sg9242182-bot/ThashuRobot/thashu/vision/data/faces/person_20/1.jpg

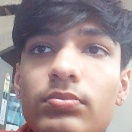
thashu/vision/data/faces/person_20/1.jpg
