sg9242182-bot/ThashuRobot/thashu/vision/data/faces/person_20/2.jpg

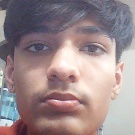
thashu/vision/data/faces/person_20/2.jpg
