sg9242182-bot/ThashuRobot/thashu/vision/data/faces/person_19/0.jpg

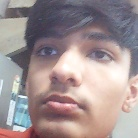
thashu/vision/data/faces/person_19/0.jpg
