sg9242182-bot/ThashuRobot/thashu/tests/vision_test.py

import cv2

cap = cv2.VideoCapture(0, cv2.CAP_V4L2)

cap.set(cv2.CAP_PROP_FOURCC, cv2.VideoWriter_fourcc(*'MJPG'))
cap.set(cv2.CAP_PROP_FRAME_WIDTH, 640)
cap.set(cv2.CAP_PROP_FRAME_HEIGHT, 480)

while True:
    ret, frame = cap.read()
    if not ret:
        print("FAILED")
        continue

    cv2.imshow("test", frame)

    if cv2.waitKey(1) & 0xFF == 27:
        break

cap.release()
cv2.destroyAllWindows()
