sg9242182-bot/ThashuRobot/(commit log)

2026-09-04 Initialize Thashu repository architecture and team workflow
    ## Development & Access Rules
    All team members may freely develop within their assigned areas. These rules exist to prevent accidental integration failures, not to restrict normal development.
    ### Rules for Niteshvar and Vishal Raj
    1. **Do not develop directly on `main`.** Use a dedicated feature/fix branch.
    2. **Do not change the approved system architecture without team approval.**
    3. **Do not silently change shared interfaces**, including APIs, communication protocols, message formats, schemas, shared data structures, or hardware/software contracts.
    4. **Do not modify another member's owned subsystem without coordination.**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
    [command_parser.cpp, command_parser.h]
2026-09-05 Add three-sensor ToF manager interface
2026-09-05 Implement three VL53L0X ToF sensors
2026-09-05 Implement three-sensor ToF manager
2026-09-05 Print ToF distance unless out of range
2026-09-05 Fix ToF manager with non-blocking continuous ranging
    [tof_manager.cpp]
2026-09-05 Print ToF test output only on obstacle detection
2026-09-06 Optimize settled eye rendering and 400kHz I2C
2026-09-06 Ensure final eye frame is rendered after transitions
2026-10-02 Add motor encoder support and proposed pin map
2026-10-03 Restore ultrasonic echo to boot-safe baseline GPIO36
2026-10-03 Correct ultrasonic pin note after GPIO12 boot failure
2026-10-03 Assign fourth encoder input to GPIO15
2026-10-03 Move provisional tilt servo signal to GPIO12
2026-10-03 Assign provisional encoder 4 GPIO and document reset validation
2026-10-03 Record provisional fourth encoder GPIO mapping
2026-10-04 Record tilt servo movement result and remaining reset test
2026-10-04 Record GPIO12 tilt servo result in Phase 1 notes
2026-10-04 Add PlatformIO environment for motor and encoder bench test
2026-10-04 Document integrated PlatformIO motor test procedure
2026-10-05 Pin VL53L0X library to official Adafruit release
2026-10-05 Add PlatformIO entry wrapper for motor sketch
2026-10-05 Compile motor sketch through PlatformIO C++ entry point
2026-10-05 Add motor sketch include directory for PlatformIO wrapper
2026-10-05 Add Arduino IDE integrated motor encoder test entry point
2026-10-05 Document Arduino IDE integrated encoder test path
2026-10-05 Record Arduino IDE integration test route
2026-10-05 Remove temporary Arduino IDE test wrapper
2026-10-05 Remove temporary build tool instructions from pin allocation
2026-10-05 Add integrated Arduino ESP32 runtime
2026-10-05 Gate integrated turns on both safety sensors
2026-10-05 Record integrated Arduino ESP32 runtime status
2026-10-05 Keep motor manager focused on motor hardware
2026-10-05 Track active movement in safety manager
2026-10-05 Add dedicated ESP32 communication manager
2026-10-05 Connect telemetry to sensor managers
2026-10-05 Expose ultrasonic reading freshness
2026-10-05 Track freshness of ultrasonic readings
2026-10-05 Feed safety watchdog from accepted protocol frames
2026-10-05 Reject stale rear ultrasonic data
2026-10-05 Document dedicated ESP32 manager ownership
2026-10-05 Remove superseded monolithic motor sketch
2026-10-05 Expose servo readiness
2026-10-05 Expose motor controller readiness
2026-10-05 Track OLED runtime health
2026-10-05 Probe OLED bus health for safety supervision
2026-10-05 Report required display and sensor startup failures
2026-10-11 Complete Phase 1 ESP32 firmware updates
2026-10-11 Align encoder ID mapping with Phase 1 pin allocation
2026-10-11 Keep safety sensor updates active on hardware fault
2026-10-11 Record serial readiness and sensor refresh finding
2026-10-15 Add servo startup diagnostics
2026-10-15 Avoid LEDC allocation during motor startup stop
2026-10-15 Track motor PWM channels for safe startup stop
2026-10-15 Preserve motor PWM stop while reserving servo channels
2026-10-15 Add isolated motor manager bench test sketch
2026-10-15 Replace stale motors sketch with isolated module test
2026-10-15 Remove misplaced nested motor test sketch
2026-10-15 Interpret motor test speed as percent up to 80
2026-10-15 Restore raw PWM command handling in motor test
2026-10-15 Allow full PWM range in isolated motor test
2026-10-17 Make camera capture lifecycle idempotent
2026-10-17 Test vision pause resume and actuator gating
2026-10-17 Test camera thread lifecycle is idempotent
2026-10-22 Update Phase 1 pin allocation for TA6586 drivers
2026-10-22 Record TA6586 driver baseline in Phase 1 checklist
2026-10-22 Adapt ESP32 managers for TA6586 motor drivers
2026-10-23 Correct motor channel directions for TA6586
2026-10-23 Record motor direction calibration for TA6586
2026-10-23 Record TA6586 motor direction correction
2026-10-23 Add encoder PID speed matching for motors
2026-10-23 Document encoder PID speed matching
2026-10-23 Record encoder PID implementation and validation status
2026-10-23 Preserve lazy PWM setup in integrated motor manager
2026-10-23 Track fresh ToF out-of-range state
2026-10-23 Distinguish fresh ToF far readings from sensor faults
2026-10-23 Report ToF out-of-range separately from unavailable sensors
2026-10-23 Update HC-SR04 trigger pin allocation
2026-10-23 Record HC-SR04 trigger pin reassignment
2026-10-23 Correct GPIO2 and GPIO32 entries in pin allocation
2026-10-23 Remap M0 input and encoder pins
2026-10-23 Document M0 startup twitch pin remap
2026-10-23 Record validated Phase 1 pin map
2026-10-23 Close M0 startup pin validation
2026-10-23 Record direct Raspberry Pi ESP32 serial test
2026-10-23 Record completed Phase 4 Raspberry Pi validation
2026-10-23 Start Phase 3 command-path trace
2026-10-23 Return ESP32 STOP dispatch status
2026-10-23 Dispatch voice STOP directly to ESP32
2026-10-24 Record forward speed presets and pending chassis validation
2026-10-24 Announce ESP32 obstacle-triggered motor stops
2026-10-24 Avoid claiming movement before ESP32 acceptance
2026-10-24 Log ESP32 safety events on serial receipt
2026-10-25 Return serial sequence for all motor directions
2026-10-25 Record directional motor transport return fix
2026-10-25 Capture ESP32 command acknowledgements
2026-10-25 Confirm motor commands and report safety rejection
2026-10-25 Distinguish obstacle from unavailable safety sensors
2026-10-25 Record motor ACK and sensor rejection reporting
2026-10-25 Harden ESP32 serial reconnection and stale device handling
2026-10-25 Fix stable ESP32 port matching during reconnect
2026-10-25 Record Pi ESP32 serial reconnect hardening
2026-10-25 Speak when ESP32 returns generic safety stop
2026-10-25 Specify sensor-verified obstacle rerouting for follow mode
2026-10-25 Publish fresh face track identities for follow logic
2026-10-25 Expose camera frame freshness for safe tracking
2026-10-25 Match Pi servo limits to ESP32 hardware bounds
2026-10-25 Integrate explicit safe servo-only follow mode
2026-10-25 Test perception track metadata without actuators
2026-10-25 Require reselection after target loss or camera gaps
2026-10-25 Record Phase 5 servo-only implementation and open safety work
2026-10-26 Stabilize face detections across camera frames
2026-10-26 Add bounded servo sweep for follow search
2026-10-26 Connect follow search scan to existing servo controller
2026-10-26 Add autonomous OLED blink timer
2026-10-26 Report rear ultrasonic no-echo as FAR
2026-10-26 Document rear ultrasonic FAR handling
2026-10-26 Add explicit servo look voice commands
2026-10-26 Add bounded manual head servo movement
2026-10-26 Route spoken look commands to head servos
2026-10-26 Cache short servo look voice replies
2026-10-26 Document Phase 5 servo look and blink updates
2026-10-26 Increase integrated rear ultrasonic timeout
2026-10-26 Increase source rear ultrasonic timeout
2026-10-26 Document wider rear ultrasonic timeout
2026-10-26 Record rear ultrasonic FAR timeout follow-up
2026-10-26 Record user verification of Phase 5 face and servo tests
2026-10-26 Expose fresh timestamped ESP32 sensor snapshots
2026-10-26 Document fresh follow sensor telemetry API
2026-10-26 Track a unique face with servos while idle
2026-10-26 Describe person search behavior in servo tracking
2026-10-26 Record upper-body tracking and chassis follow gates
2026-10-26 Log upper-body track changes for Phase 5 validation
2026-10-26 Hold follow camera tilt and track with pan only
2026-10-26 Fix follow tilt and pan-track upper body
2026-10-26 Define fixed-tilt camera range calibration for follow
2026-10-26 Raise fixed upper-body follow camera angle
2026-10-26 Document raised follow camera tilt
2026-10-26 Raise follow camera tilt slightly
2026-10-26 Raise follow camera tilt another step
2026-10-26 Set follow camera tilt to 65 degrees
2026-10-27 Pin Pi-compatible MediaPipe Pose Lite runtime
2026-10-27 Suppress wake triggers during servo movement
2026-10-27 Track servo command time for wake suppression
2026-10-27 Guard wake detection during servo movement
2026-10-29 Remove global servo wake guard tracking
2026-10-29 Add bounded camera-range chassis follow pulses
2026-10-29 Record bounded chassis-follow implementation
2026-10-29 Update follow response for bounded motor control
2026-10-29 Track cached follow-start WAV acceptance
2026-10-29 fix: gate identity matches on aligned multi-frame evidence
2026-10-29 feat: persist only explicitly confirmed enrollment samples
2026-10-29 feat: collect face enrollment samples from a single stable track
2026-10-29 fix: accept zero-valued face track id during enrollment
2026-10-29 feat: add explicit confirmed face enrollment voice flow
2026-10-29 fix: align ArcFace crops to current detector boxes
2026-10-29 fix: allow cancellation during every enrollment stage
2026-10-30 Correct chassis turn mapping and add timed servo moves
2026-10-30 Increase manual servo look travel and speed
2026-10-30 Record turn direction and manual servo motion update
2026-10-30 Document physical motor index layout
2026-10-30 Print physical motor index map in isolated test
2026-10-30 Report physical motor map at ESP32 startup
2026-10-30 Group turn motors by chassis side
2026-10-30 Document face enrollment spelling retry flow
2026-11-01 Route name-led remember requests into face enrollment
2026-11-01 Add confirmed voice flow to forget saved memories
2026-11-01 Record face false-positive mitigation and calibration requirement
2026-11-01 Append pose-diverse samples to confirmed face identities
2026-11-01 Exclude same-name samples from lookalike overlap warning
2026-11-01 Add guarded face sample adaptation
2026-11-01 Collect guarded high-confidence face samples
2026-11-02 Tighten face identity acceptance gates
2026-11-02 Collect twelve pose-diverse face enrollment samples
2026-11-02 Simplify fifteen-sample face enrollment
2026-11-02 Document fifteen-view face enrollment flow
2026-11-02 Add confirmed voice flow for place labels
2026-11-02 Handle low-feature frames during place capture
2026-11-02 Require fresh distinct frames for place recognition
2026-11-02 Expire stale place evidence before frame deduplication
2026-11-03 Detect and reject overlapping face enrollment samples
2026-11-03 Document overlap-filtered face enrollment
2026-11-03 Extend overlap-filtered enrollment window
2026-11-04 Record Phase 8 Raspberry Pi acceptance as complete
2026-11-04 Add exact place filtering to person event recall
2026-11-05 Re-arm recognition WAV after identity re-enrollment
2026-11-05 Add isolated live-camera face model benchmark
2026-11-05 Add isolated live-camera dlib face test
2026-11-05 Wire opt-in dlib backend into vision lifecycle
2026-11-05 Throttle optional dlib vision inference
2026-11-06 Ignore serial read interruption during shutdown
2026-11-06 Retry audio resume after USB device changes
2026-11-07 Record Phase 11 cold-start timing sample
2026-11-07 Record warm Phase 11 timing samples
2026-11-07 Record repeated Piper timing sample
2026-11-07 Pin Piper splitter dependencies for MediaPipe
2026-11-07 Use venv CMake for Raspberry Pi Piper build
2026-11-07 Record three-run Phase 11 timing sample
2026-11-07 Record Pi Qwen thread-count benchmark
2026-11-07 Allow Pi LLM thread count tuning
2026-11-07 Document LLM thread tuning experiment
2026-11-07 Record full-app LLM thread comparison
2026-11-07 Record repeat Phase 11 vision latency sample
